KavinduMethpura/ChiaSing-Hardware-and-web/docs/component.docx

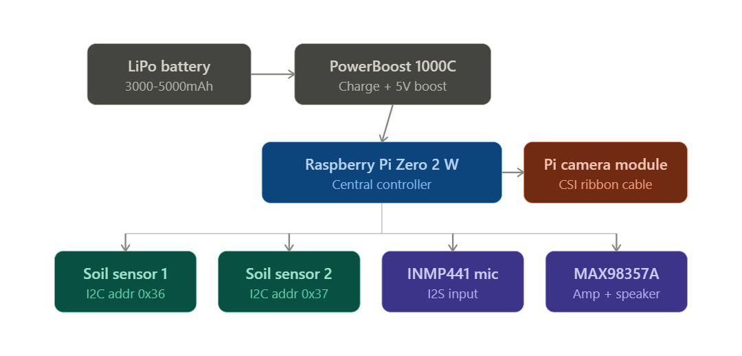
[picture p1: figure]

Component | Part | Image | Available Qty | Qty | For five projects(what we have to buy)

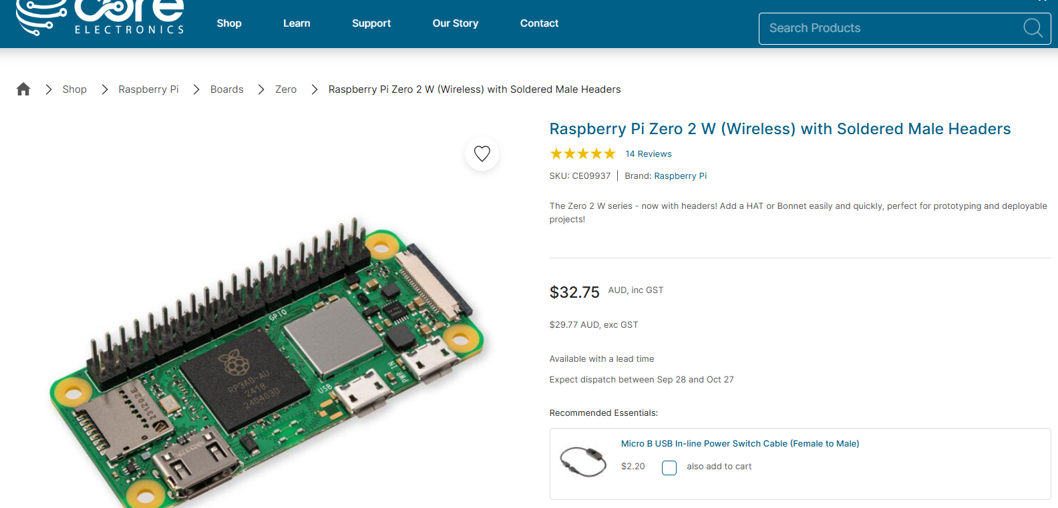
[picture p2: figure]

Compute | Raspberry Pi Zero 2 W | | 1 | 1 | 4

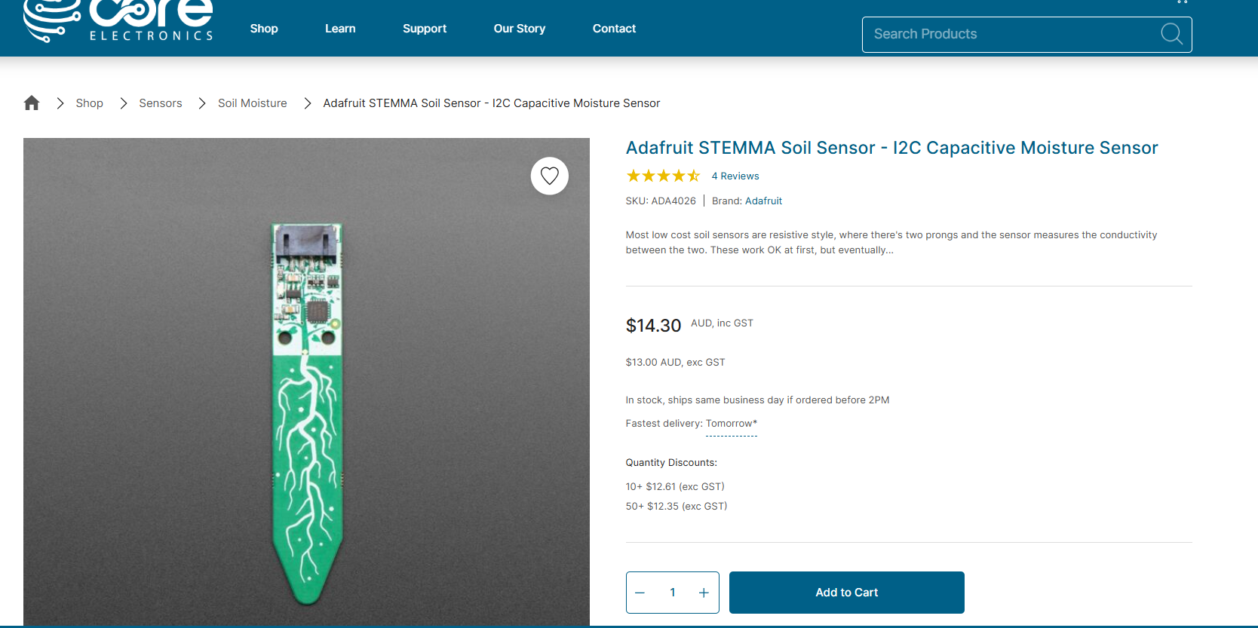
[picture p3: figure]

Soil sensors | Adafruit STEMMA Soil Sensor | | 3 | 2 | 7

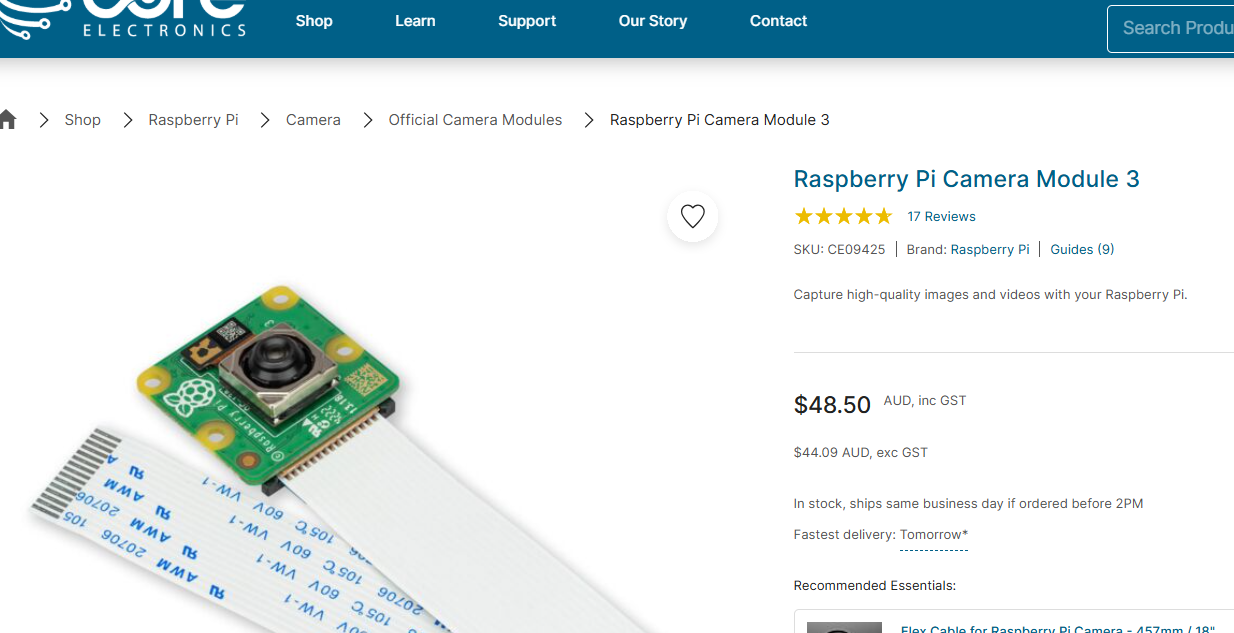
[picture p4: figure]

Camera | Pi Camera Module + Zero-specific CSI ribbon | | 2 | 1 | 3

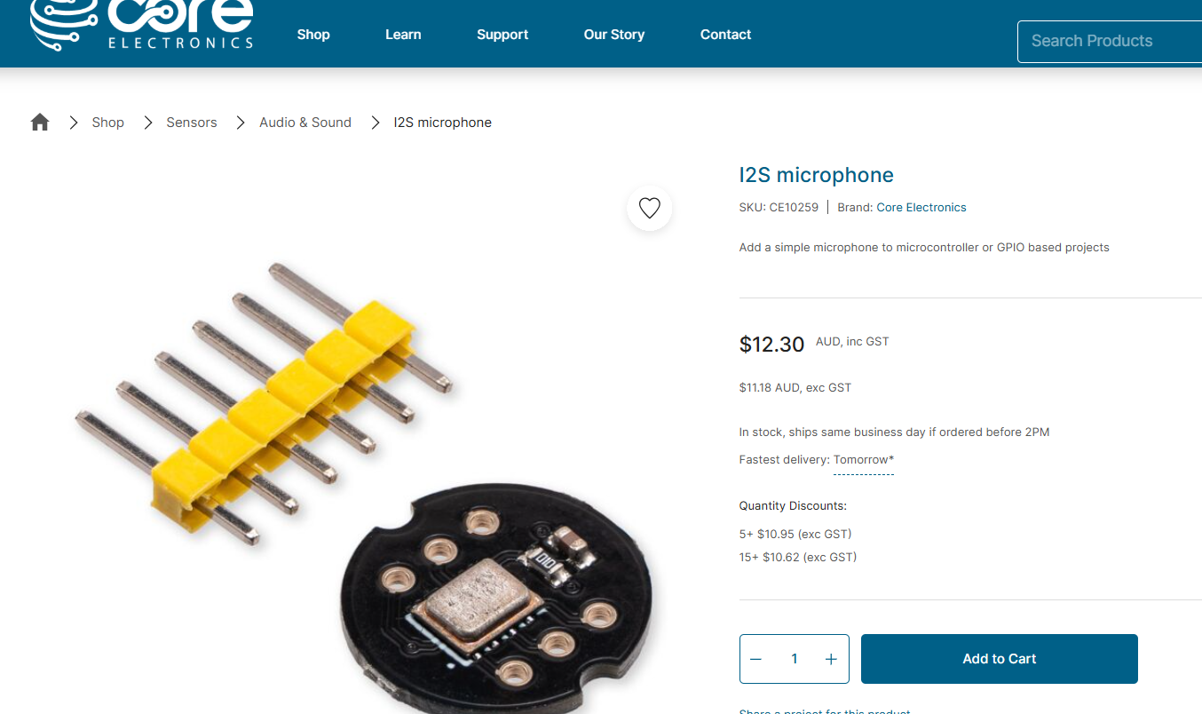
[picture p5: figure]

Mic | INMP441 I2S MEMS mic breakout | | 0 | 1 | 5

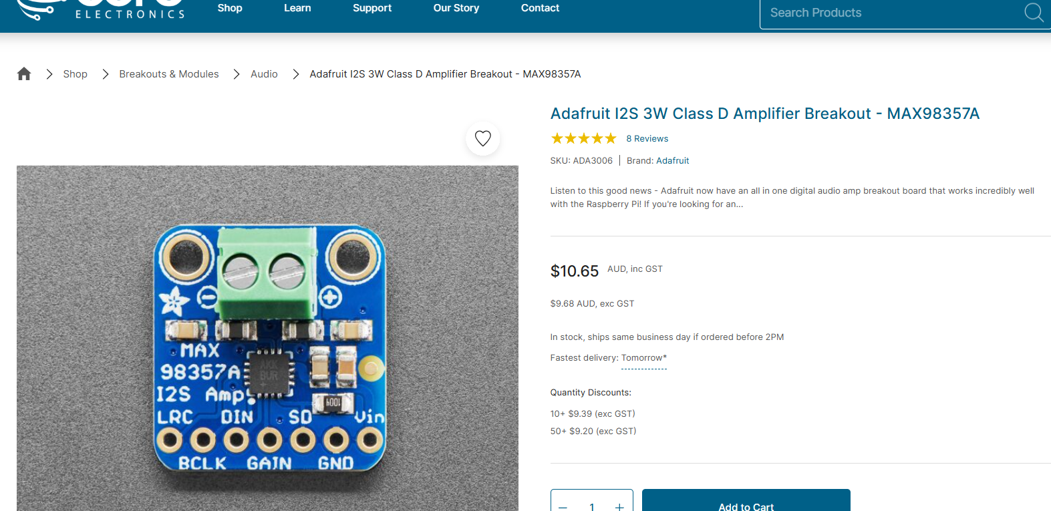
[picture p6: figure]

Speaker amp | MAX98357A I2S Class-D amp breakout | | 3 | 2 | 7

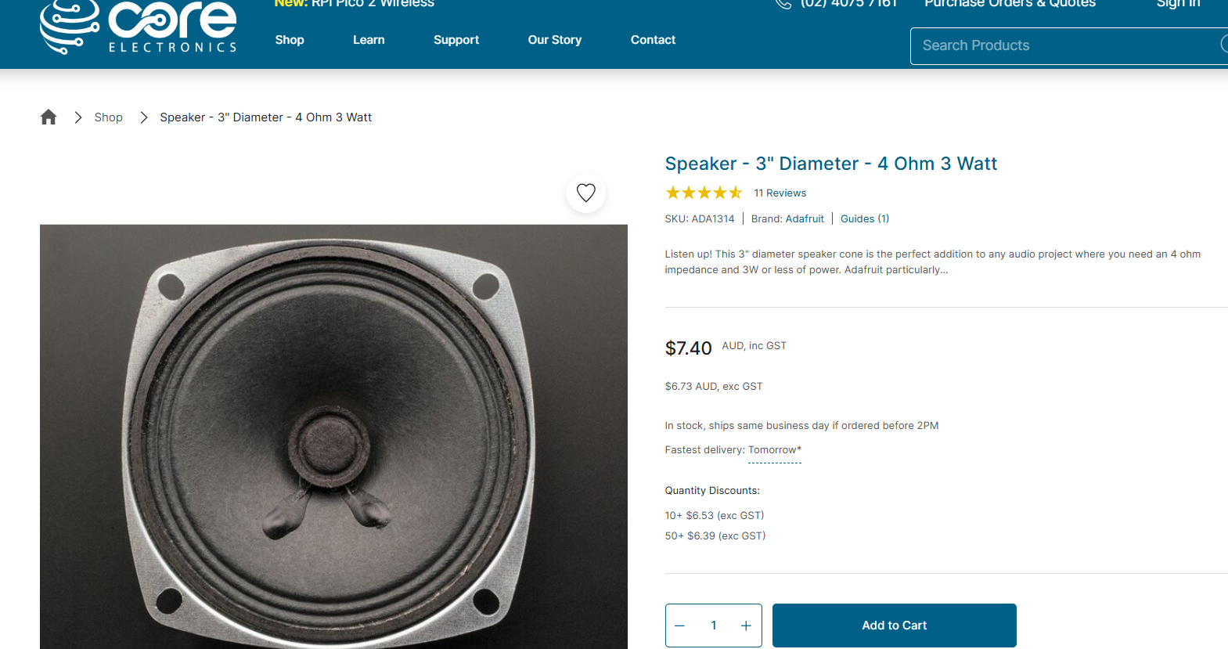
[picture p7: figure]

Speaker | Small 4Ω/3W speaker (28-36mm) | | 0 | 2 | 10

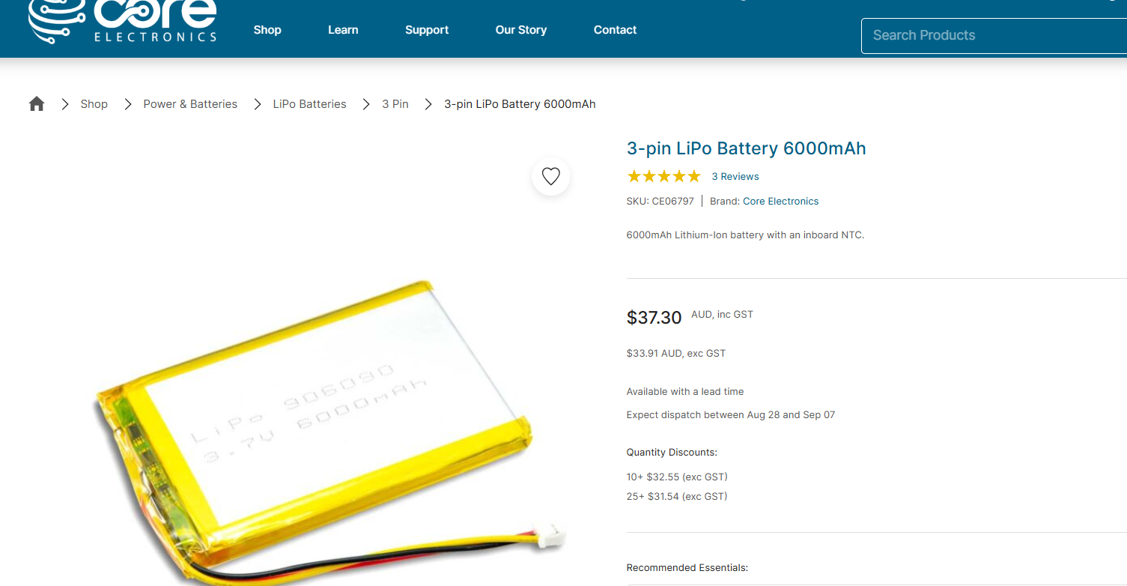
[picture p8: figure]

Battery | LiPo, 1100mah, JST-PH connector | | 0 | 1 | 5

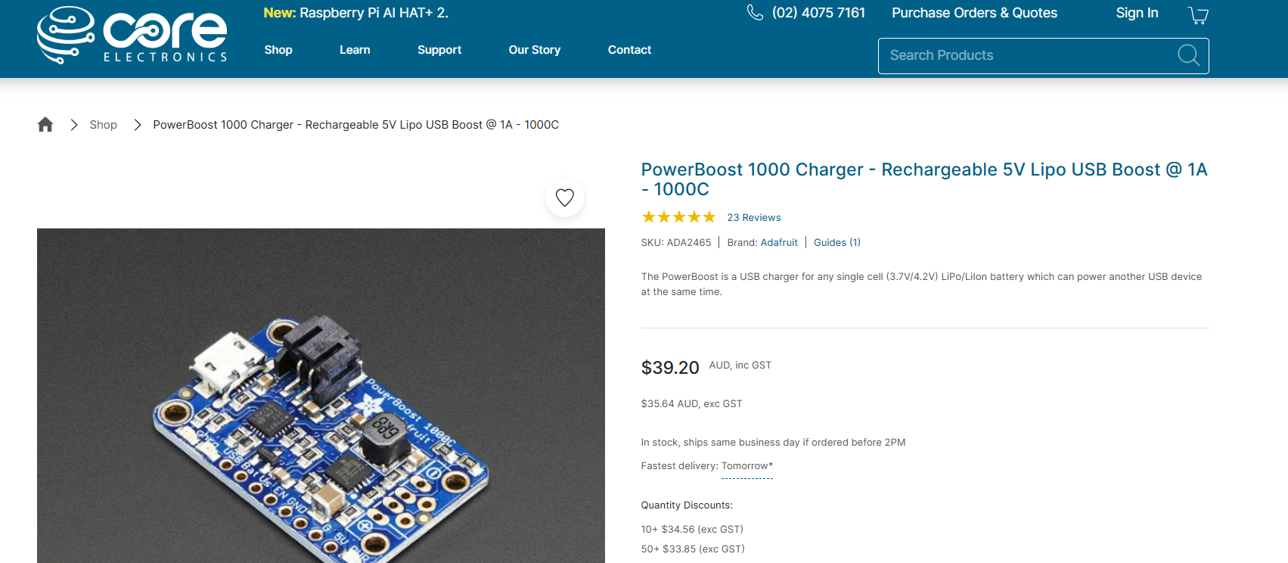
[picture p9: figure]

Charger/boost | Adafruit PowerBoost 1000C | | 0 | 1 | 5
