KavinduMethpura/ChiaSing-Hardware-and-web/design/earcove2rv2.stl

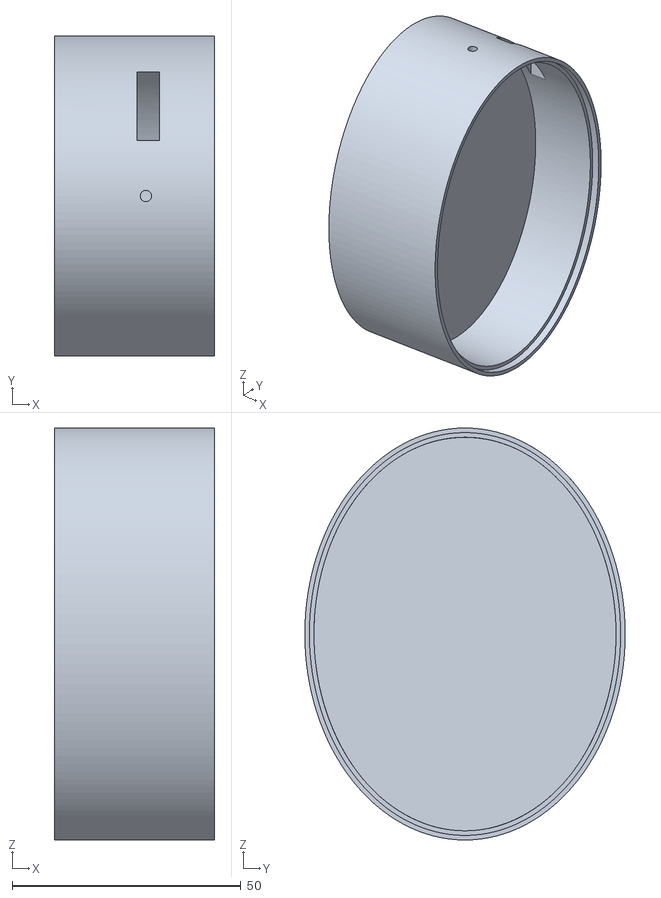
[picture p10: CAD file, 2026-10-07]
design/earcove2rv2.stl
35.0 x 70.0 x 90.0
