KavinduMethpura/ChiaSing-Hardware-and-web/design/camholder2.stl

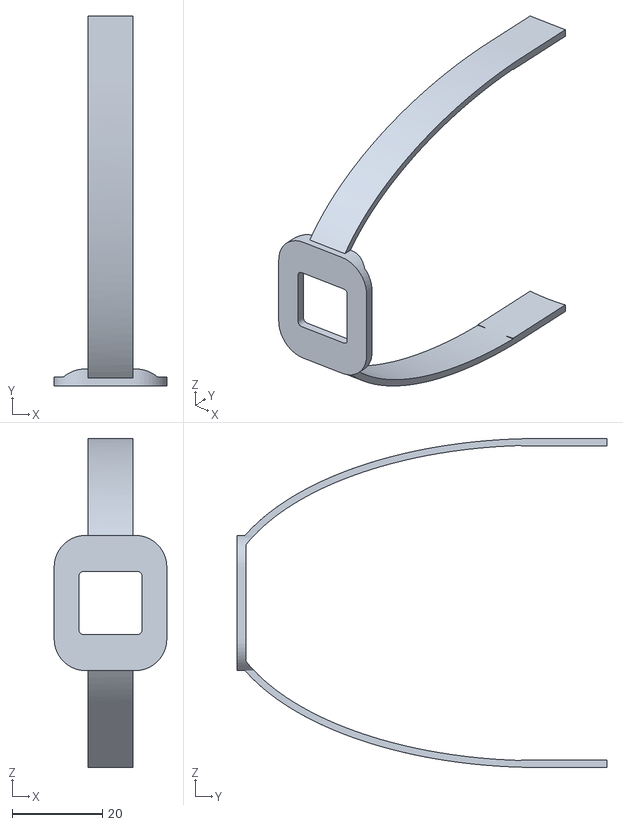
[picture p11: CAD file, 2026-10-07]
design/camholder2.stl
25.0 x 82.0 x 73.0
