KavinduMethpura/ChiaSing-Hardware-and-web/design/connector.stl

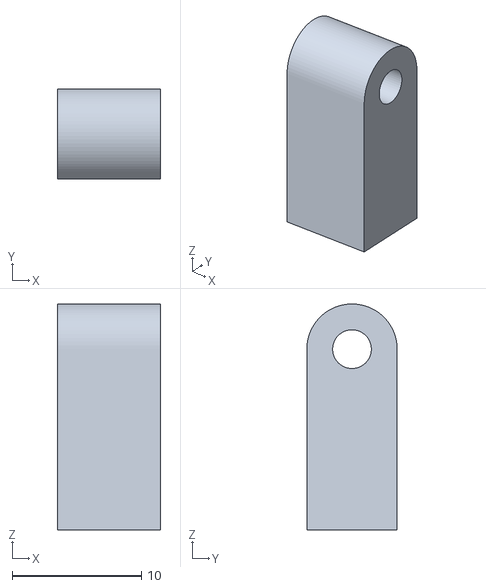
[picture p12: CAD file, 2026-10-07]
design/connector.stl
8.00 x 7.00 x 17.5
