KavinduMethpura/ChiaSing-Hardware-and-web/design/speaker.stl

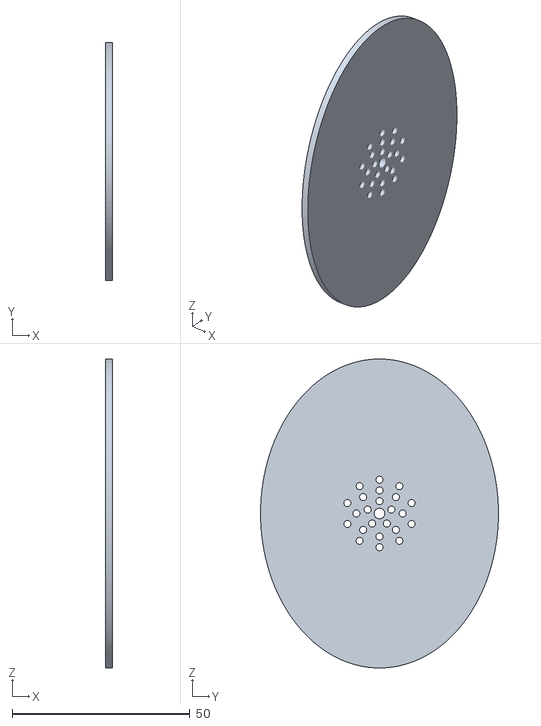
[picture p13: CAD file, 2026-10-07]
design/speaker.stl
2.00 x 67.0 x 87.0
