KavinduMethpura/ChiaSing-Hardware-and-web/design/plantcover.stl

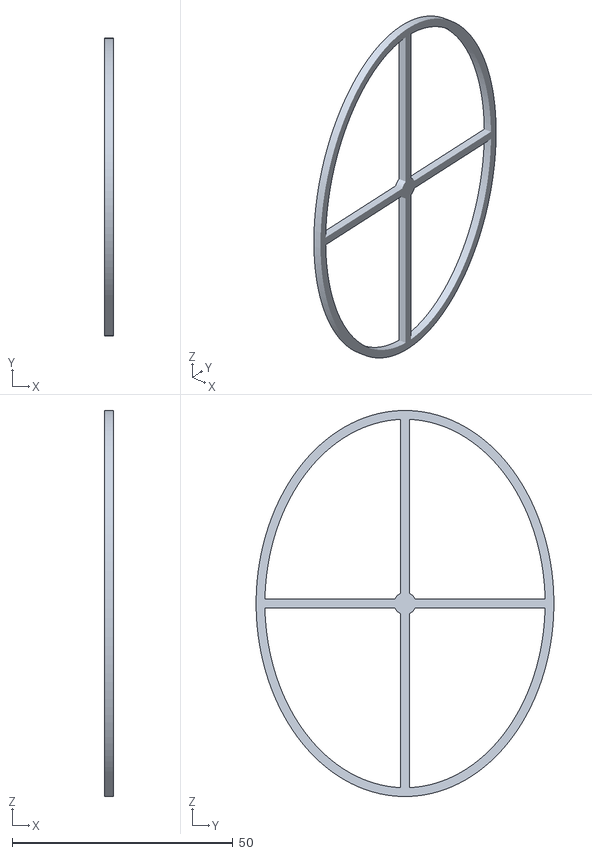
[picture p14: CAD file, 2026-10-07]
design/plantcover.stl
2.00 x 67.5 x 87.5
