KavinduMethpura/ChiaSing-Hardware-and-web/design/extension.stl

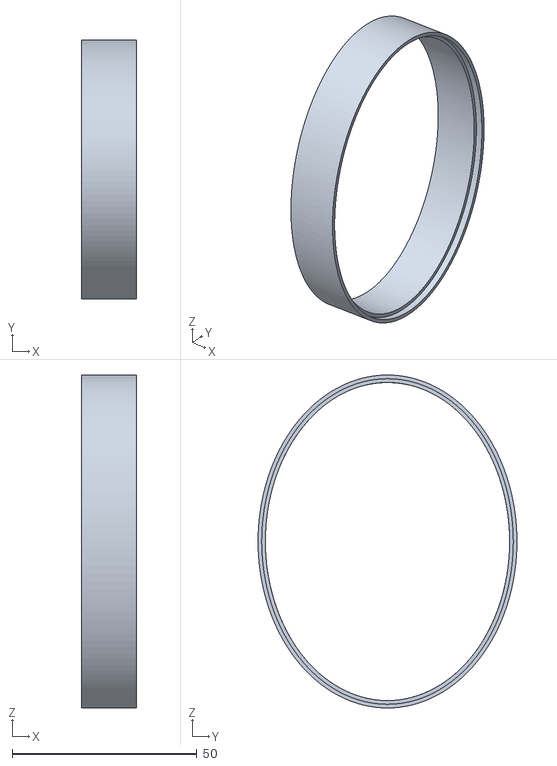
[picture p15: CAD file, 2026-10-07]
design/extension.stl
15.0 x 70.0 x 90.0
