KavinduMethpura/ChiaSing-Hardware-and-web/design/junction rod1.3mf

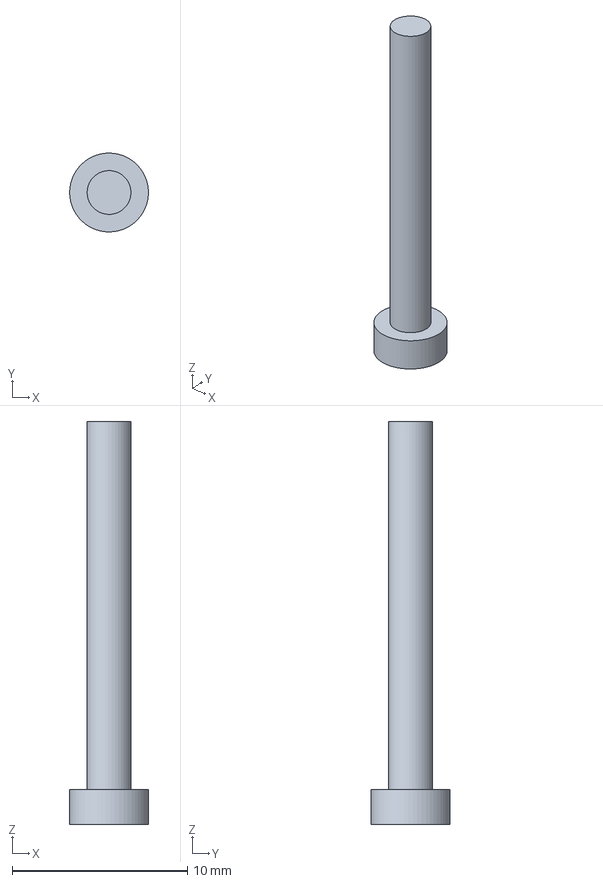
[picture p16: CAD file, 2026-10-07]
design/junction rod1.3mf
4.50 x 4.50 x 23.0 mm
