KavinduMethpura/ChiaSing-Hardware-and-web/design/plantcoverV2.stl

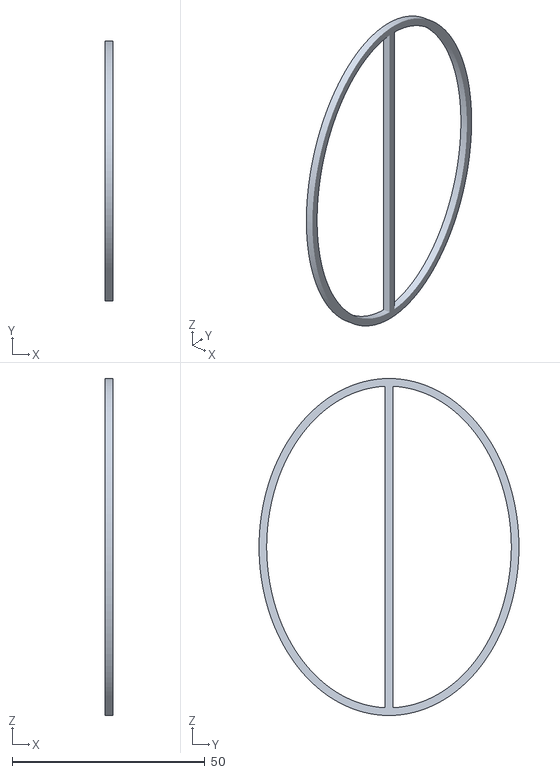
[picture p17: CAD file, 2026-10-07]
design/plantcoverV2.stl
2.00 x 67.5 x 87.5
