KavinduMethpura/ChiaSing-Hardware-and-web/design/headcover2.stl

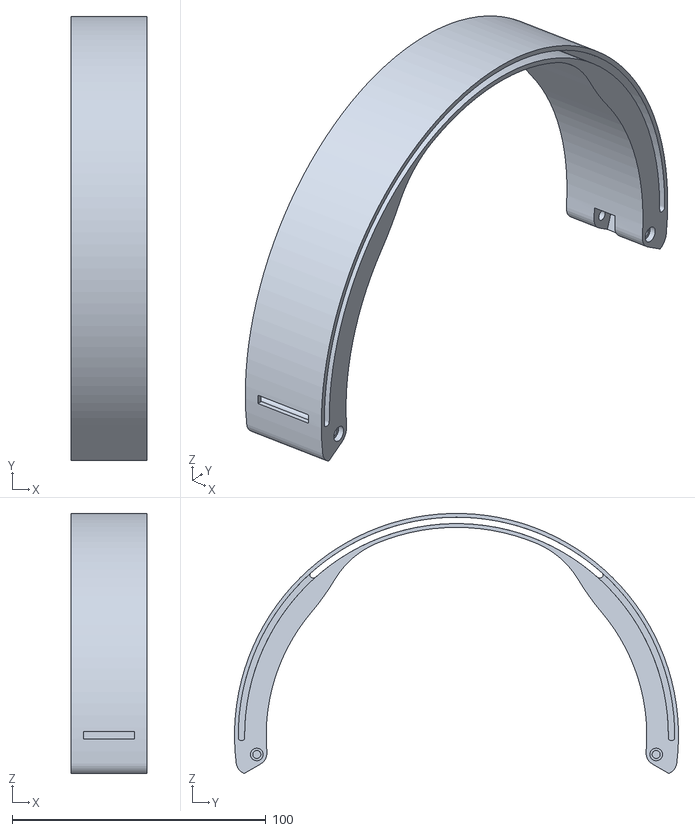
[picture p18: CAD file, 2026-10-07]
design/headcover2.stl
30.0 x 175.0 x 102.5
