KavinduMethpura/ChiaSing-Hardware-and-web/design/junction rod2.stl

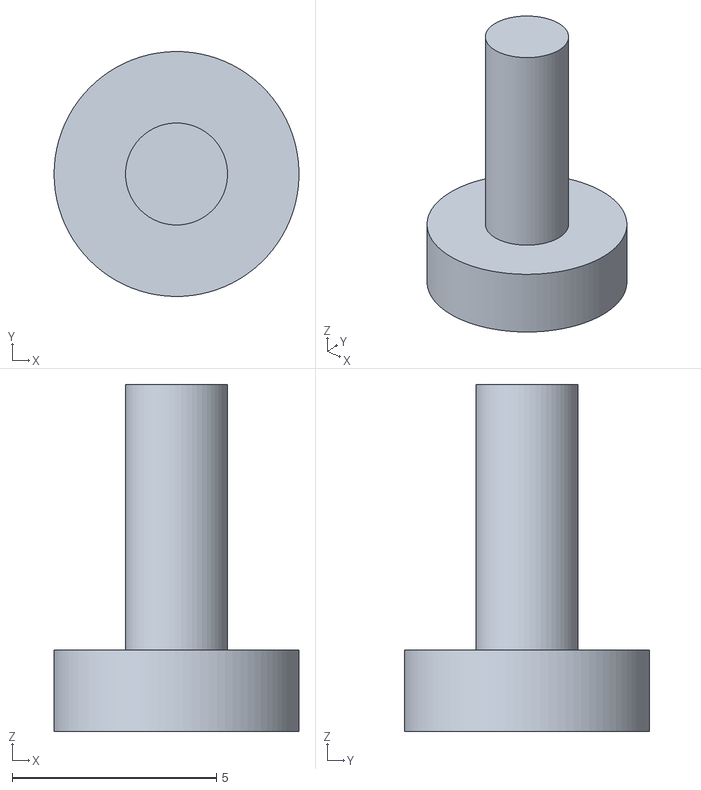
[picture p19: CAD file, 2026-10-07]
design/junction rod2.stl
6.00 x 6.00 x 8.50
