KavinduMethpura/ChiaSing-Hardware-and-web/design/earcoverv2.1.stl

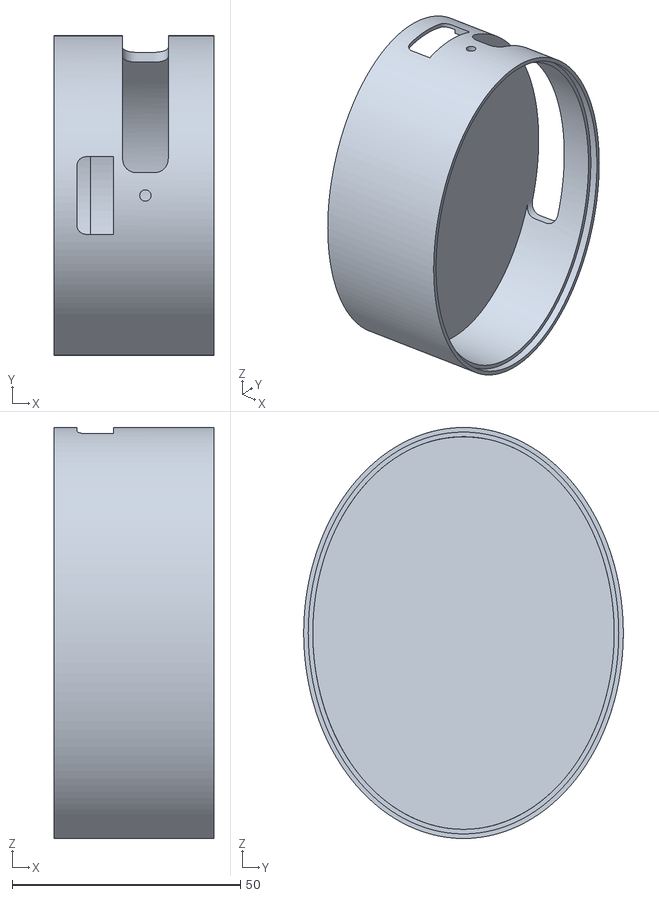
[picture p20: CAD file, 2026-10-07]
design/earcoverv2.1.stl
35.0 x 70.0 x 90.0
