KavinduMethpura/ChiaSing-Hardware-and-web/(list of files, cad)

Other CAD files:
design/junction rod1.stl
