KavinduMethpura/ChiaSing-Hardware-and-web/docs/I2CSoilSensorViaPython.pdf

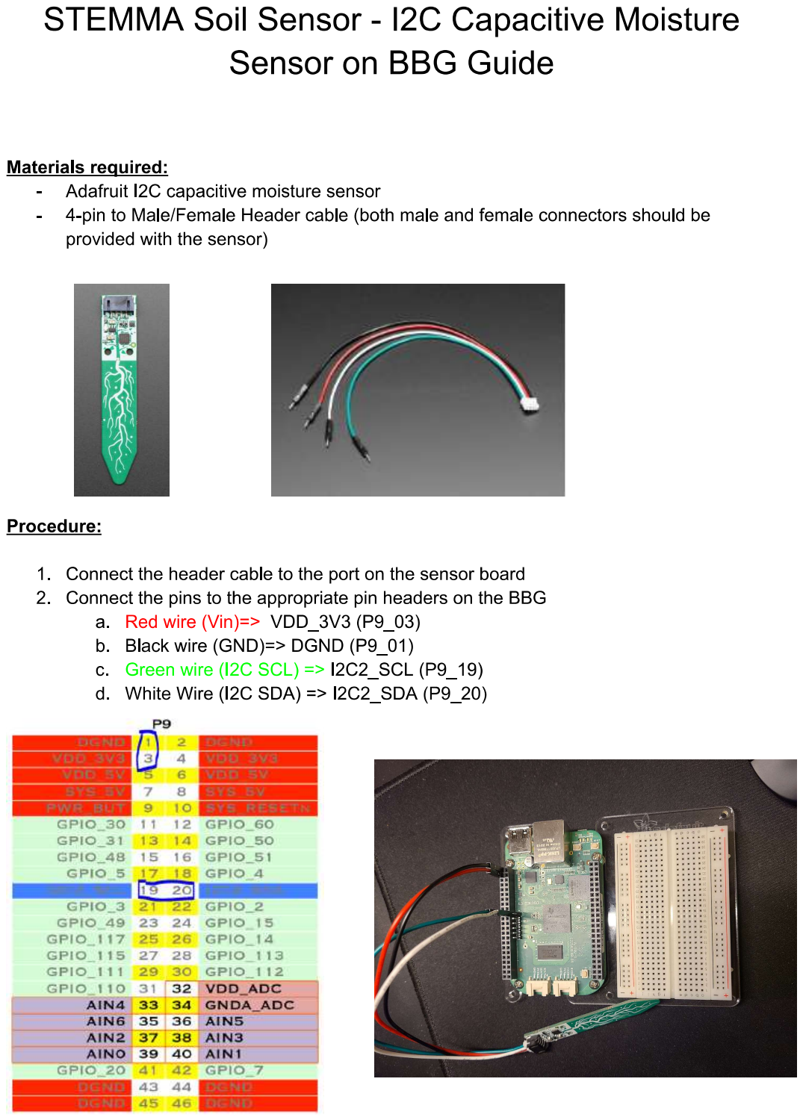
[picture p21: page 1]

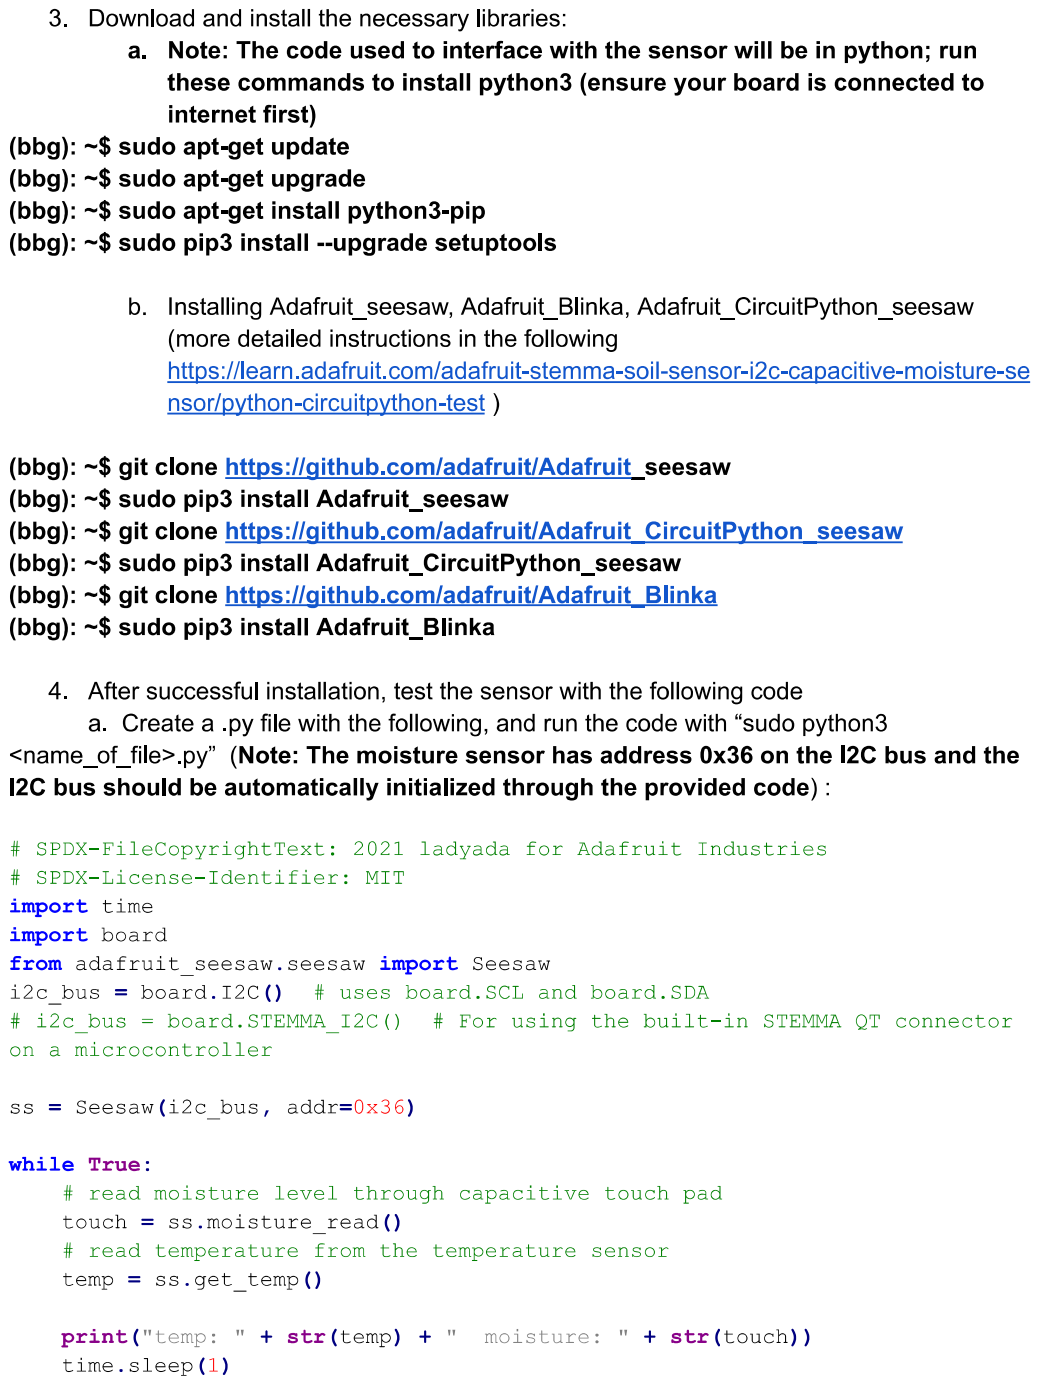
[picture p22: page 2]

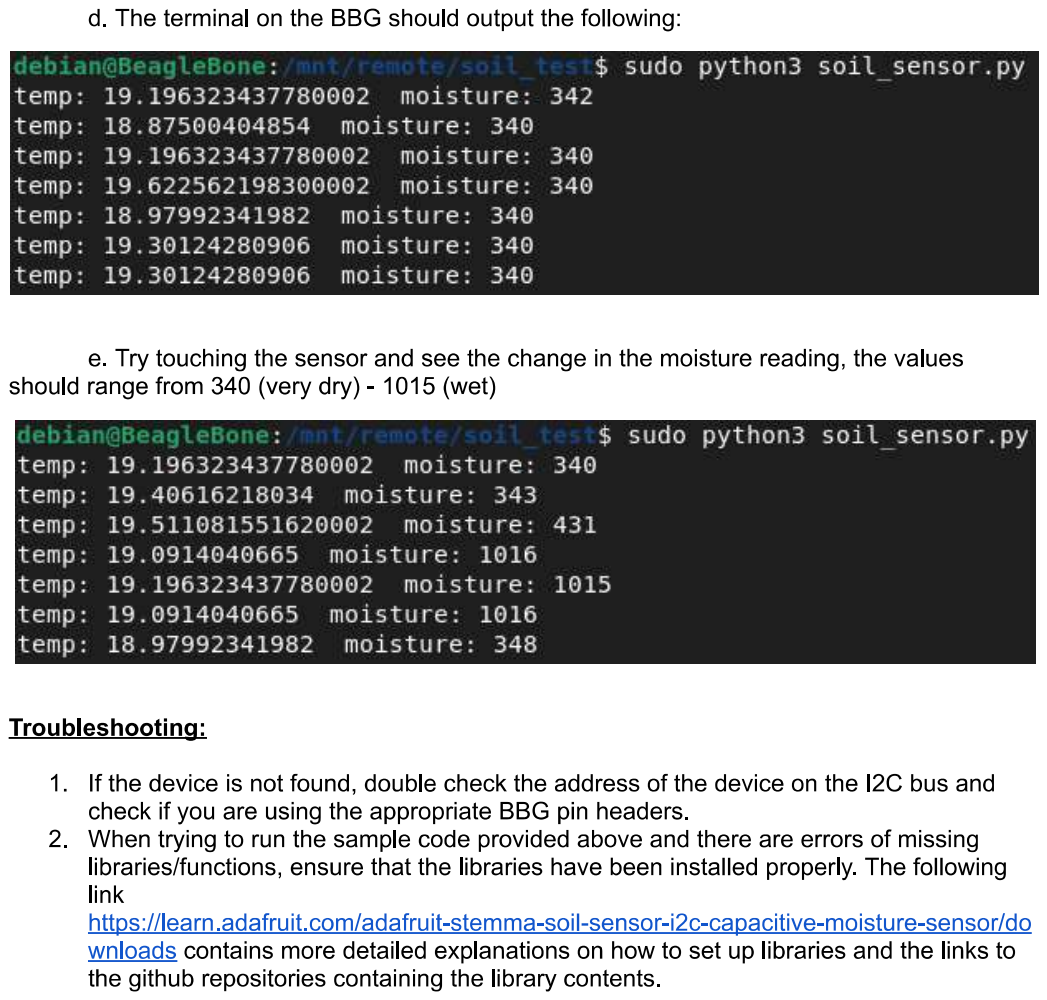
[picture p23: page 3]
